comradef191/Cupcake24/Gen3Electronics/Driver-2.3/EAGLE/info.md

These are the original 2008 files, but saved using a version of Eagle I downloaded last year to make them openable in KiCad 8.0
