comradef191/Cupcake24/Gen3Electronics/Extruder-2.2/extruder-controller.kicad_pcb

## KiCad design Gen3Electronics/Extruder-2.2/extruder-controller.kicad_pcb (2024-11-07)

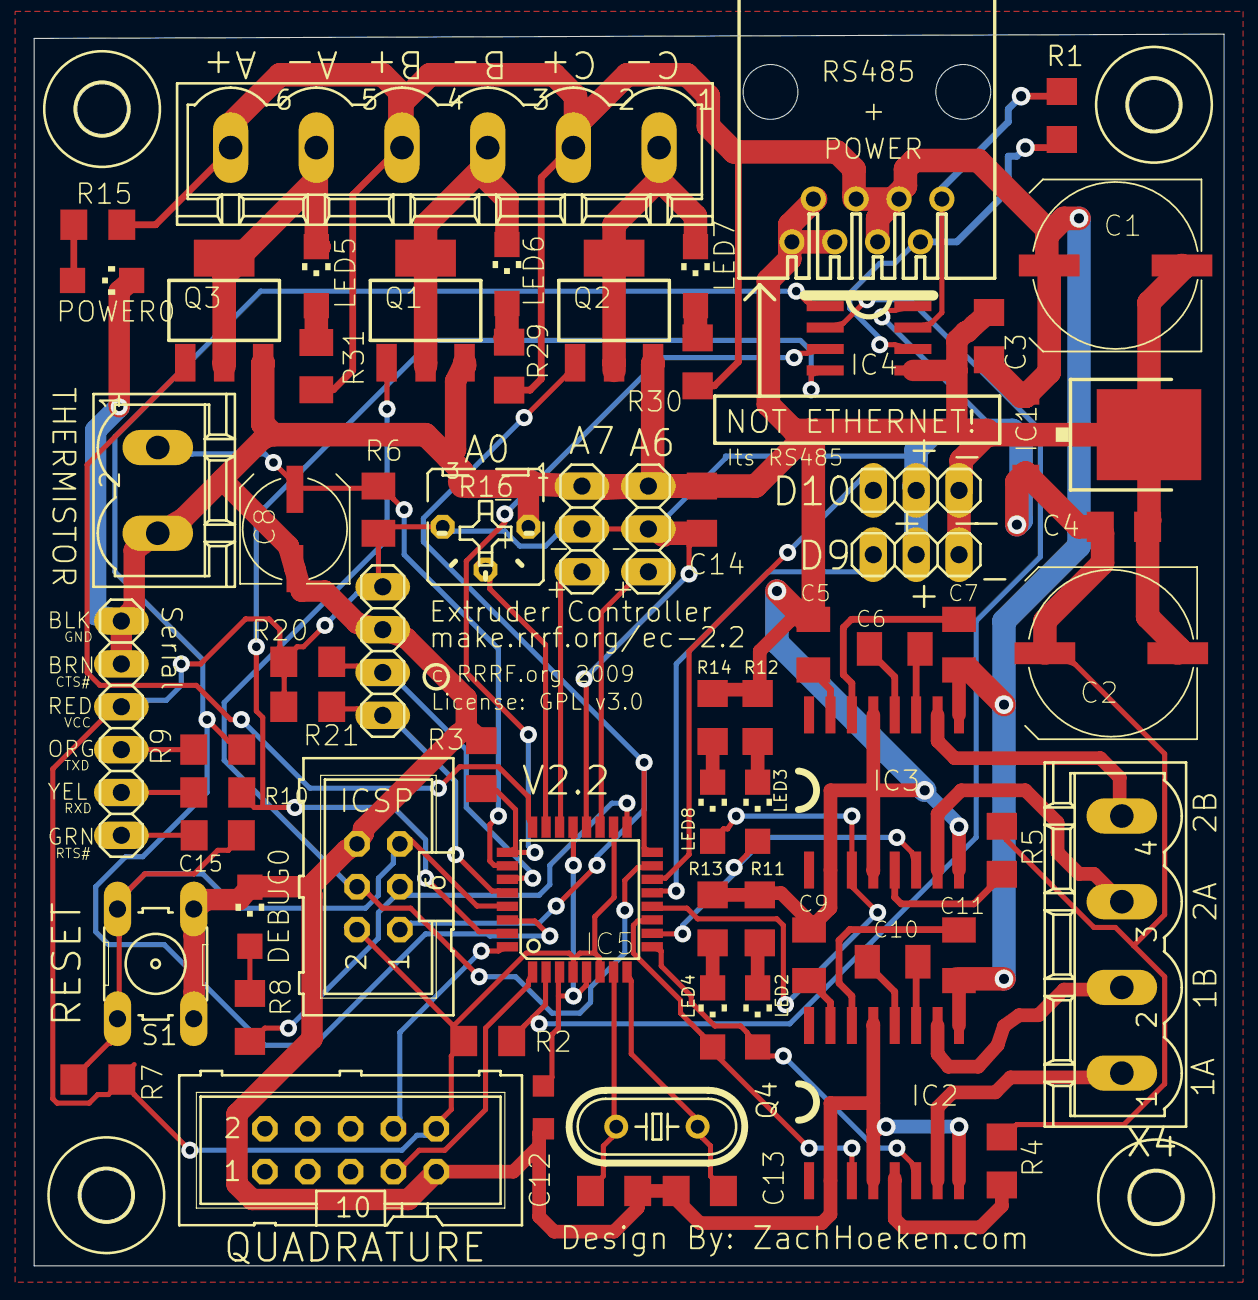
[picture p1: board extruder-controller.kicad_pcb from above]

Board: 2 copper layers, 70.5 x 73.0 mm, 71 parts (0 on the bottom side), 61 nets.

Parts:
C1, C2: 100uF; UD-10X10_NICHICON
C3, C4, C14, C15: 100nF; C1206
C5, C9: .22uF; C1206K
C6, C7, C10, C11: 100nF; C1206K
C8: 10uF; UD-6,3X5,8_NICHICON
C12, C13: 16pf; C1206
DEBUG0: CHIPLED_1206
H1, H2, H3, H4: MOUNT-HOLE3.0; 3,0
IC1: 7805DT; TO252
IC2, IC3: A3949; SO16W
IC4: SN75176ASOIC; SO08
IC5: ATMEGA168; TQFP32-08
J1: 520426-4
JP2, JP3, JP6, JP7: 1X03
JP4: 1X04
JP5: 1X06
LED2: 1; CHIPLED_1206
LED3: 2; CHIPLED_1206
LED4, LED5, LED6, LED7, LED8: CHIPLED_1206
POWER0: CHIPLED_1206
Q1, Q2, Q3: NIF5002; SOT223
Q4: 16MHZ; HC49_S
R1: 180; R1206
R2, R3: 4.7k; R1206
R4, R5, R7: 10K; R1206
R6: 4.7K; M1206
R8, R9, R10, R11, R12, R13, R14, R15, R29, R30: 1K; R1206
R16: B25P
R20, R21: 4.7K; R1206
R31: 1K; M1206
S1: B3F-10XX
SV1: ML6
SV2: ML10
X1: MSTBV6
X3: MSTBV2
X4: MSTBV4

Connections:
+12V: C1.+, C3.1, C7.2, C11.2, IC1.1, IC2.9, IC3.9, J1.3, J1.4, J1.5, R15.2, R29.2, R30.2, R31.2, X1.2, X1.4, X1.6
A0: IC5.23, R16.S
A1: IC5.24, Q3.1
A2: IC4.3, IC5.25, R3.1
A3: C8.+, IC5.26, R6.1, X3.1
A6: IC5.19, JP6.3
A7: IC5.22, JP7.3
D2: IC5.32, SV2.8
D3: IC5.1, SV2.7
D4: IC4.2, IC5.2, R2.1
D5: IC2.6, IC5.9, LED2.A
D6: IC3.6, IC5.10, LED3.A
D7: IC2.3, IC5.11, LED4.A
D8: IC3.3, IC5.12, LED8.A
D9: IC5.13, JP3.3
D10: IC5.14, JP2.3
D11: IC5.15, Q1.1, SV1.4
D12: IC5.16, Q2.1, SV1.1
D13: IC5.17, R8.2, SV1.3
GND: C1.-, C2.-, C3.2, C4.2, C5.1, C8.-, C9.1, C12.1, C13.1, C14.1, DEBUG0.C, IC1.3, IC2.2, IC2.4, IC2.8, IC2.13, IC3.2, IC3.4, IC3.8, IC3.13, IC4.5, J1.6, J1.7, J1.8, JP2.1, JP3.1, JP4.2, JP5.1, JP5.2, JP6.1, JP7.1, POWER0.C, Q1.3, Q2.3, Q3.3, R3.2, R11.2, R12.2, R13.1, R14.1, R16.A, S1.3, S1.4, SV1.6, SV2.9, X3.2
GNDA: IC5.3, IC5.5, IC5.21
unnamed: IC4.7, J1.1, R1.2
unnamed: IC4.6, J1.2, R1.1
unnamed: C9.2, IC2.15
unnamed: IC2.7, X4.1
unnamed: IC2.10, X4.2
unnamed: C10.2, IC2.12
unnamed: C10.1, IC2.11
unnamed: DEBUG0.A, R8.1
unnamed: C11.1, IC2.14
unnamed: IC3.7, X4.3
unnamed: C5.2, IC3.15
unnamed: IC2.5, R4.2
unnamed: C6.2, IC3.12
unnamed: C6.1, IC3.11
unnamed: C7.1, IC3.14
unnamed: IC3.5, R5.2
unnamed: IC3.10, X4.4
unnamed: LED2.C, R11.1
unnamed: LED3.C, R12.1
unnamed: C14.2, IC5.20
unnamed: JP5.5, R10.1
unnamed: JP5.4, R9.1
unnamed: LED4.C, R13.2
unnamed: LED8.C, R14.2
unnamed: POWER0.A, R15.1
unnamed: C12.2, IC5.7, Q4.2
unnamed: C13.2, IC5.8, Q4.1
unnamed: LED7.C, Q2.2, Q2.4, X1.1
unnamed: LED6.C, Q1.2, Q1.4, X1.3
unnamed: LED5.C, Q3.2, Q3.4, X1.5
unnamed: LED5.A, R31.1
unnamed: LED6.A, R29.1
unnamed: LED7.A, R30.1
RESET: C15.1, IC5.29, R7.1, S1.1, S1.2, SV1.5
RTS#: C15.2, JP5.6
RX: IC4.1, IC5.30, R9.2
SCL: IC5.28, JP4.4, R21.1
SDA: IC5.27, JP4.3, R20.1
TX: IC4.4, IC5.31, R10.2
VCC: C2.+, C4.1, IC1.2, IC4.8, IC5.4, IC5.6, IC5.18, JP2.2, JP3.2, JP4.1, JP5.3, JP6.2, JP7.2, R2.2, R4.1, R5.1, R6.2, R7.2, R16.E, R20.2, R21.2, SV1.2, SV2.10
