comradef191/Cupcake24/Gen3Electronics/Motherboard-1.2/motherboard.kicad_pcb

## KiCad design Gen3Electronics/Motherboard-1.2/motherboard.kicad_pcb (2024-11-07)

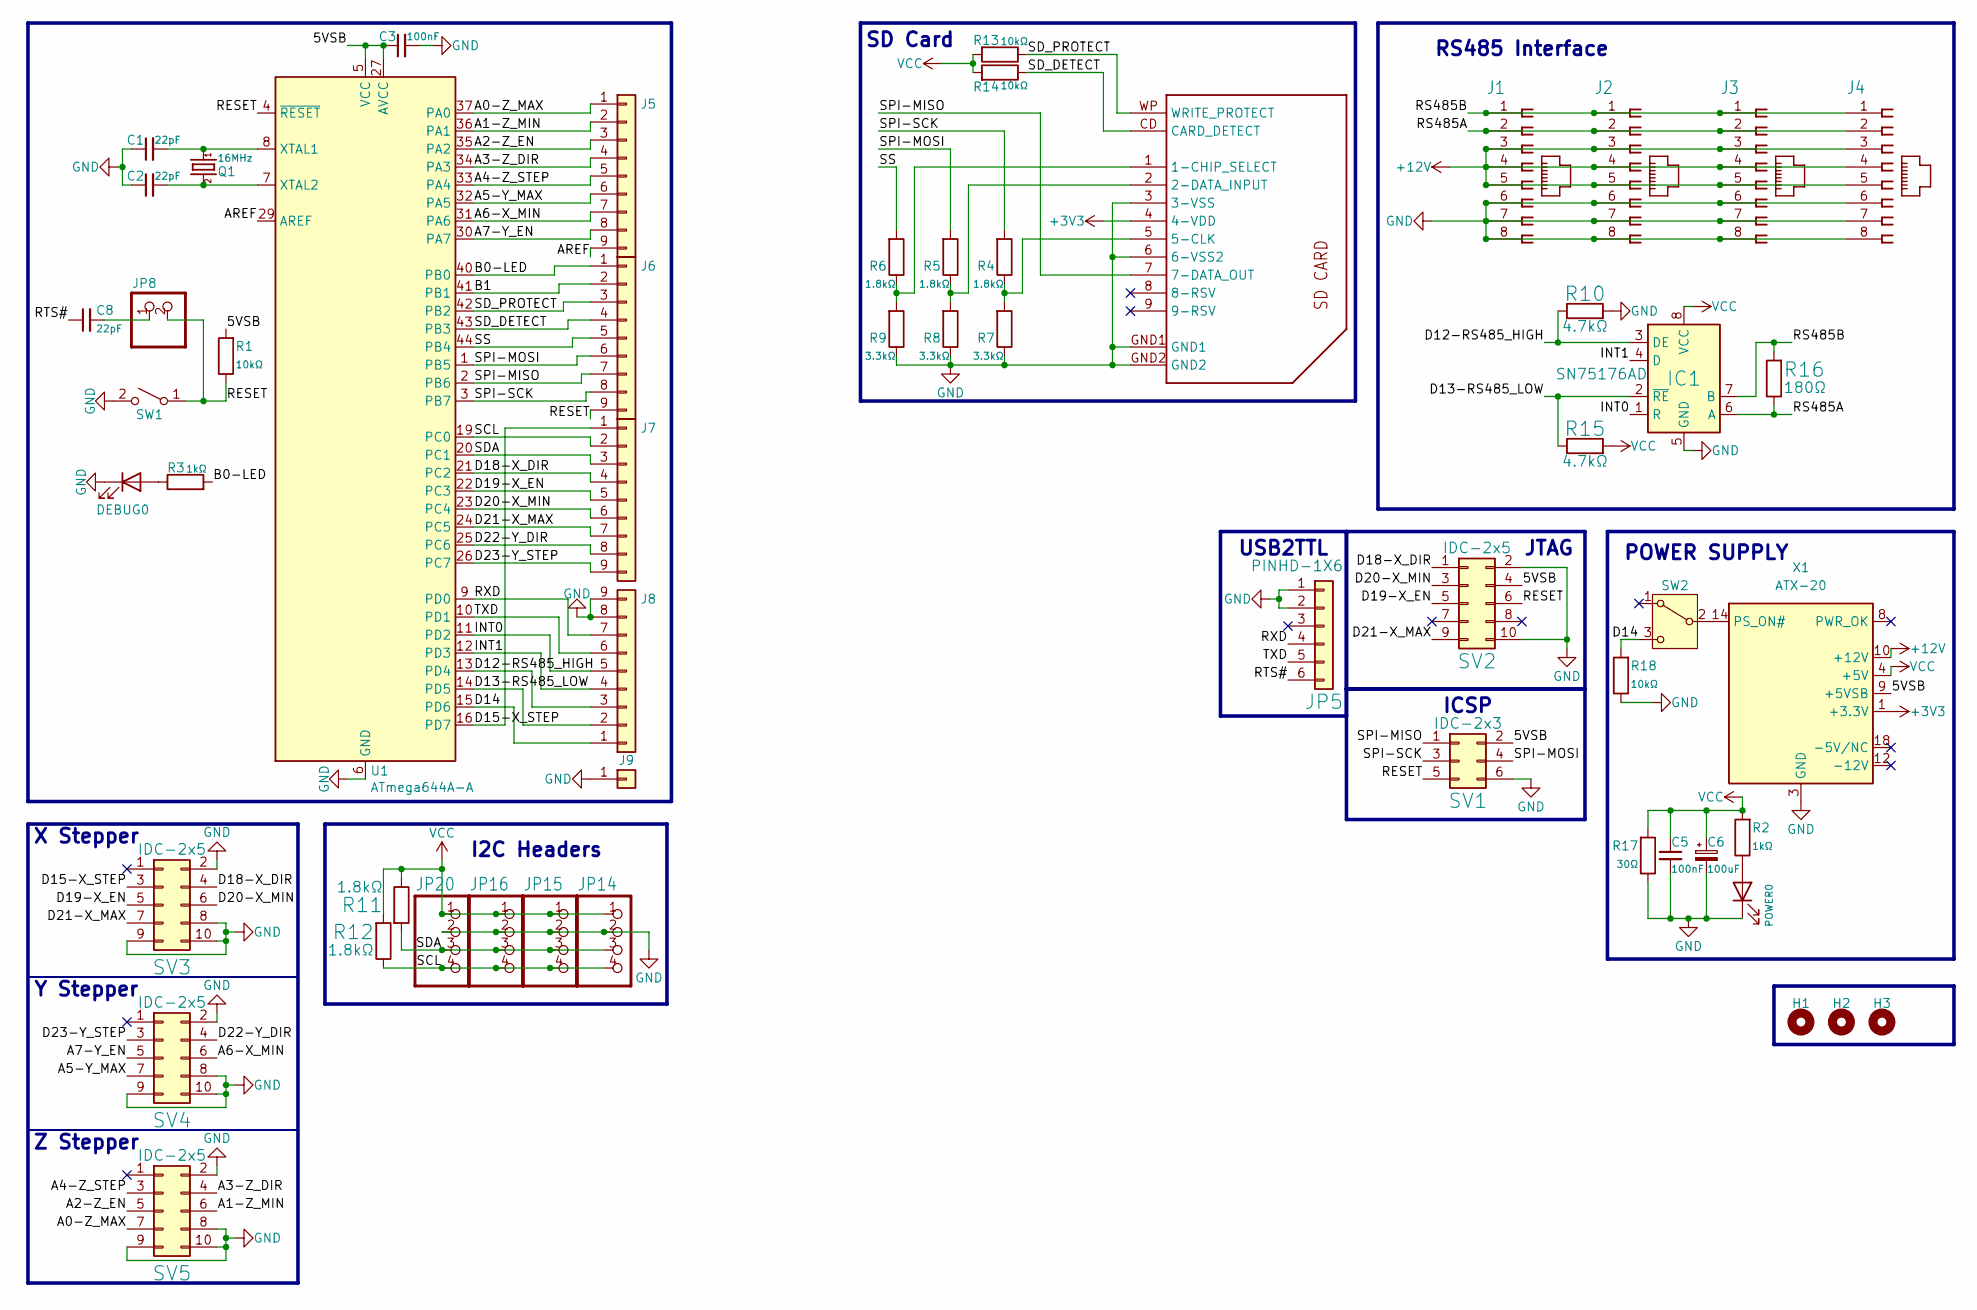
[picture p2: schematic motherboard.kicad_sch, RepRap Motherboard]

Parts:
C1, C2, C8: 22pF; C_1206_3216Metric_Pad1.33x1.80mm_HandSolder
C3, C5: 100nF; C_1206_3216Metric_Pad1.33x1.80mm_HandSolder
C6: 100uF; CP_Radial_D8.0mm_P3.50mm; LCSC C2749
DEBUG0: LEDCHIPLED_1206; LED_1206_3216Metric
H1, H2, H3: M3 Mounting Hole; M3 Mounting Hole ~ Classic
IC1: SN75176AD; SOIC-8_3.9x4.9mm_P1.27mm
J1, J2, J3, J4: 555164-1
J5, J6, J7, J8: Conn_01x09; PinSocket_1x09_P2.54mm_Vertical
J9: Conn_01x01; PinSocket_1x01_P2.54mm_Vertical
JP5: PINHD-1X6; 1X06
JP8: PINHD-1X2; 1X02
JP14, JP15, JP16, JP20: PINHD-1X4; 1X04
POWER0: LEDCHIPLED_1206; LED_1206_3216Metric
Q1: 16MHz; Crystal_HC49-U_Vertical
R1, R13, R14, R18: 10kΩ; R_1206_3216Metric_Pad1.30x1.75mm_HandSolder
R2, R3: 1kΩ; R_1206_3216Metric_Pad1.30x1.75mm_HandSolder
R4, R5, R6, R11, R12: 1.8kΩ; R_1206_3216Metric_Pad1.30x1.75mm_HandSolder
R7, R8, R9: 3.3kΩ; R_1206_3216Metric_Pad1.30x1.75mm_HandSolder
R10, R15: 4.7kΩ; R_1206_3216Metric_Pad1.30x1.75mm_HandSolder
R16: 180Ω; R_1206_3216Metric_Pad1.30x1.75mm_HandSolder
R17: 30Ω; R_Axial_Power_L20.0mm_W6.4mm_P22.40mm; LCSC C334301
SV1: IDC-2x3; IDC-Header_2x03_P2.54mm_Vertical
SV2, SV3, SV4, SV5: IDC-2x5; IDC-Header_2x05_P2.54mm_Vertical
SW1: SW_SPST; SW_PUSH_6mm_H5mm; LCSC C5340135
SW2: SW_SPDT; SW-TH_SHOU-HAN_SS12D10G4
U1: ATmega644A-A; TQFP-44_10x10mm_P0.8mm; LCSC C38349
U$8: SDCARD; 3M-SDCARD
X1: ATX-20; Molex_Mini-Fit_Jr_5566-20A2_2x10_P4.20mm_Vertical

Connections:
+3V3: U$8.4 (4-VDD), X1.1 (+3.3V), X1.2 (+3.3V), X1.11 (+3.3V)
+12V: J1.3, J1.4, J1.5, J2.3, J2.4, J2.5, J3.3, J3.4, J3.5, J4.3, J4.4, J4.5, X1.10 (+12V)
/5VSB: C3.1, R1.2, SV1.2, SV2.4, U1.5 (VCC), U1.17 (VCC), U1.27 (AVCC), U1.38 (VCC), X1.9 (+5VSB)
/A0-Z_MAX: J5.1, SV5.7, U1.37 (PA0)
/A1-Z_MIN: J5.2, SV5.6, U1.36 (PA1)
/A2-Z_EN: J5.3, SV5.5, U1.35 (PA2)
/A3-Z_DIR: J5.4, SV5.4, U1.34 (PA3)
/A4-Z_STEP: J5.5, SV5.3, U1.33 (PA4)
/A5-Y_MAX: J5.6, SV4.7, U1.32 (PA5)
/A6-X_MIN: J5.7, SV4.6, U1.31 (PA6)
/A7-Y_EN: J5.8, SV4.5, U1.30 (PA7)
/AREF: J5.9, U1.29 (AREF)
/B0-LED: J6.1, R3.2, U1.40 (PB0)
/B1: J6.2, U1.41 (PB1)
/D12-RS485_HIGH: IC1.3 (DE), J8.3, R10.1, U1.13 (PD4)
/D13-RS485_LOW: IC1.2 (~RE), J8.2, R15.1, U1.14 (PD5)
/D14: J8.1, R18.2, SW2.3 (C), U1.15 (PD6)
/D15-X_STEP: J7.1, SV3.3, U1.16 (PD7)
/D18-X_DIR: J7.4, SV2.1, SV3.4, U1.21 (PC2)
/D19-X_EN: J7.5, SV2.5, SV3.5, U1.22 (PC3)
/D20-X_MIN: J7.6, SV2.3, SV3.6, U1.23 (PC4)
/D21-X_MAX: J7.7, SV2.9, SV3.7, U1.24 (PC5)
/D22-Y_DIR: J7.8, SV4.4, U1.25 (PC6)
/D23-Y_STEP: J7.9, SV4.3, U1.26 (PC7)
/INT0: IC1.1 (R), J8.5, U1.11 (PD2)
/INT1: IC1.4 (D), J8.4, U1.12 (PD3)
/RESET: J6.9, JP8.2, R1.1, SV1.5, SV2.6, SW1.1 (A), U1.4 (~RESET)
/RS485A: IC1.6 (A), J1.2, J2.2, J3.2, J4.2, R16.1
/RS485B: IC1.7 (B), J1.1, J2.1, J3.1, J4.1, R16.2
/RTS#: C8.1, JP5.6
/RXD: J8.7, JP5.4, U1.9 (PD0)
/SCL: J7.2, JP14.4, JP15.4, JP16.4, JP20.4, R12.1, U1.19 (PC0)
/SDA: J7.3, JP14.3, JP15.3, JP16.3, JP20.3, R11.2, U1.20 (PC1)
/SD_DETECT: J6.4, R14.1, U1.43 (PB3), U$8.CD (CARD_DETECT)
/SD_PROTECT: J6.3, R13.1, U1.42 (PB2), U$8.WP (WRITE_PROTECT)
/SPI-MISO: J6.7, SV1.1, U1.2 (PB6), U$8.7 (7-DATA_OUT)
/SPI-MOSI: J6.6, R5.2, SV1.4, U1.1 (PB5)
/SPI-SCK: J6.8, R4.2, SV1.3, U1.3 (PB7)
/SS: J6.5, R6.2, U1.44 (PB4)
/TXD: J8.6, JP5.5, U1.10 (PD1)
GND: C1.1, C2.1, C3.2, C5.2, C6.2, DEBUG0.1 (K), IC1.5 (GND), J1.6, J1.7, J1.8, J2.6, J2.7, J2.8, J3.6, J3.7, J3.8, J4.6, J4.7, J4.8, J8.8, J8.9, J9.1, JP5.1, JP5.2, JP14.2, JP15.2, JP16.2, JP20.2, POWER0.1 (K), R7.1, R8.1, R9.1, R10.2, R17.1, R18.1, SV1.6, SV2.2, SV2.10, SV3.2, SV3.8, SV3.9, SV3.10, SV4.2, SV4.8, SV4.9, SV4.10, SV5.2, SV5.8, SV5.9, SV5.10, SW1.2 (B), U1.6 (GND), U1.18 (GND), U1.28 (GND), U1.39 (GND), U$8.3 (3-VSS), U$8.6 (6-VSS2), U$8.GND1, U$8.GND2, X1.3 (GND), X1.5 (GND), X1.7 (GND), X1.13 (GND), X1.15 (GND), X1.16 (GND), X1.17 (GND)
unnamed: C8.2, JP8.1
unnamed: DEBUG0.2 (A), R3.1
unnamed: POWER0.2 (A), R2.1
unnamed: SW2.2 (B), X1.14 (PS_ON#)
unnamed: C1.2, Q1.1, U1.8 (XTAL1)
unnamed: C2.2, Q1.2, U1.7 (XTAL2)
unnamed: R6.1, R9.2, U$8.1 (1-CHIP_SELECT)
unnamed: R5.1, R8.2, U$8.2 (2-DATA_INPUT)
unnamed: R4.1, R7.2, U$8.5 (5-CLK)
VCC: C5.1, C6.1, IC1.8 (VCC), JP14.1, JP15.1, JP16.1, JP20.1, R2.2, R11.1, R12.2, R13.2, R14.2, R15.2, R17.2, X1.4 (+5V), X1.6 (+5V), X1.19 (+5V), X1.20 (+5V)

Notes on the sheet:
Z Stepper
USB2TTL
SD Card
JTAG
RS485 Interface
Y Stepper
ICSP
X Stepper
POWER SUPPLY
I2C Headers

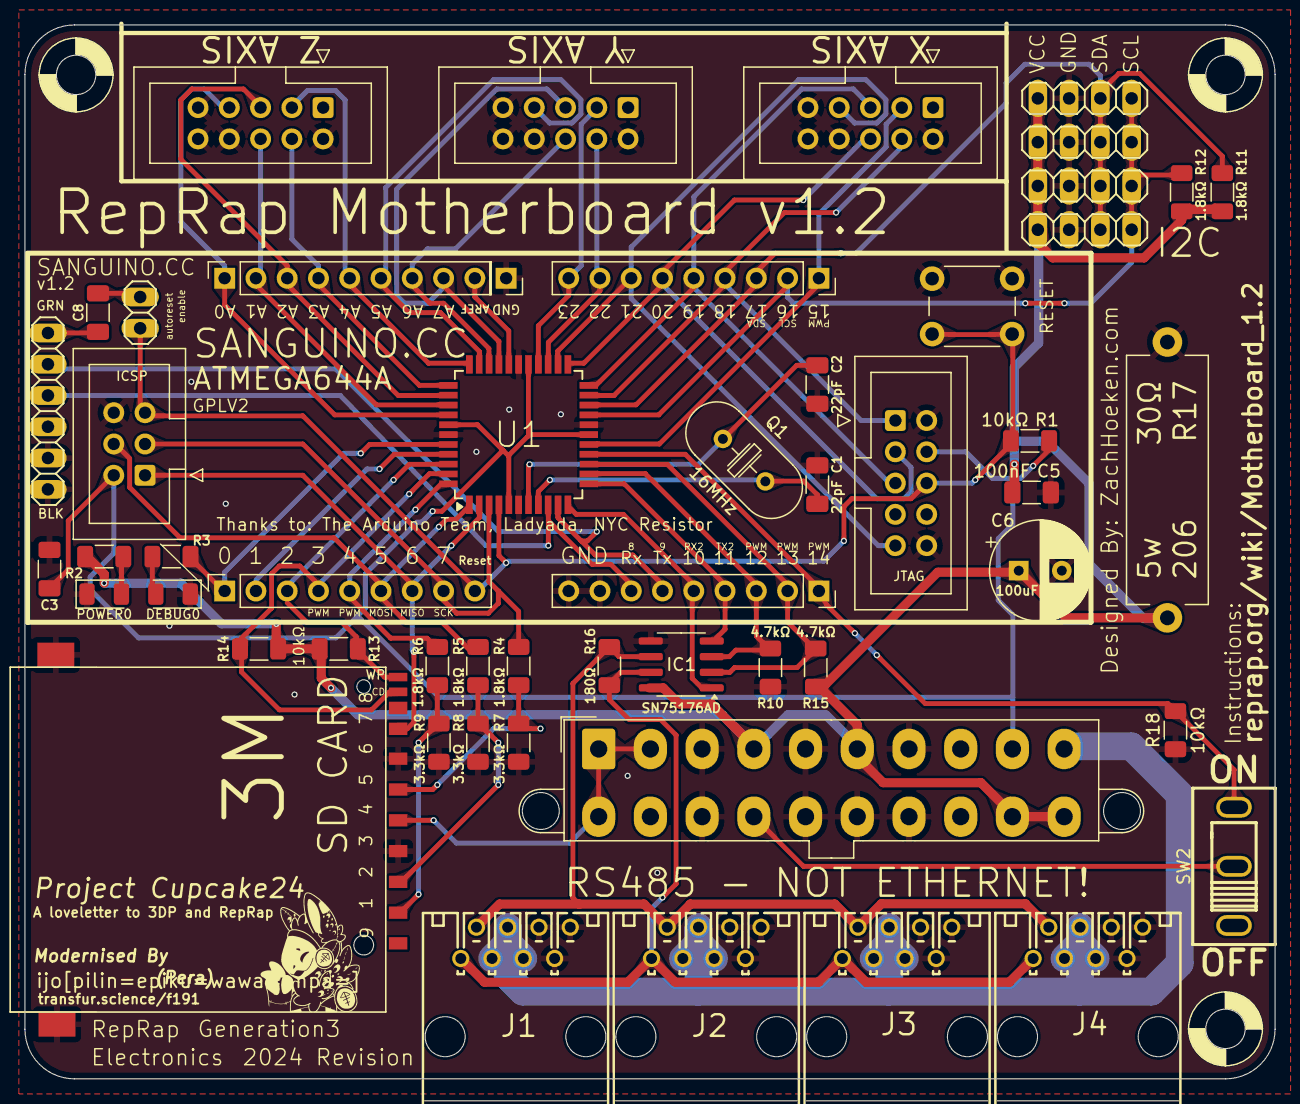
[picture p3: board motherboard.kicad_pcb from above]

Board: 2 copper layers, 101.5 x 85.6 mm, 56 parts (0 on the bottom side), 51 nets.
