comradef191/Cupcake24/Gen3Electronics/Driver-2.3/stepper-motor-driver.kicad_pcb

## KiCad design Gen3Electronics/Driver-2.3/stepper-motor-driver.kicad_pcb (2024-11-07)

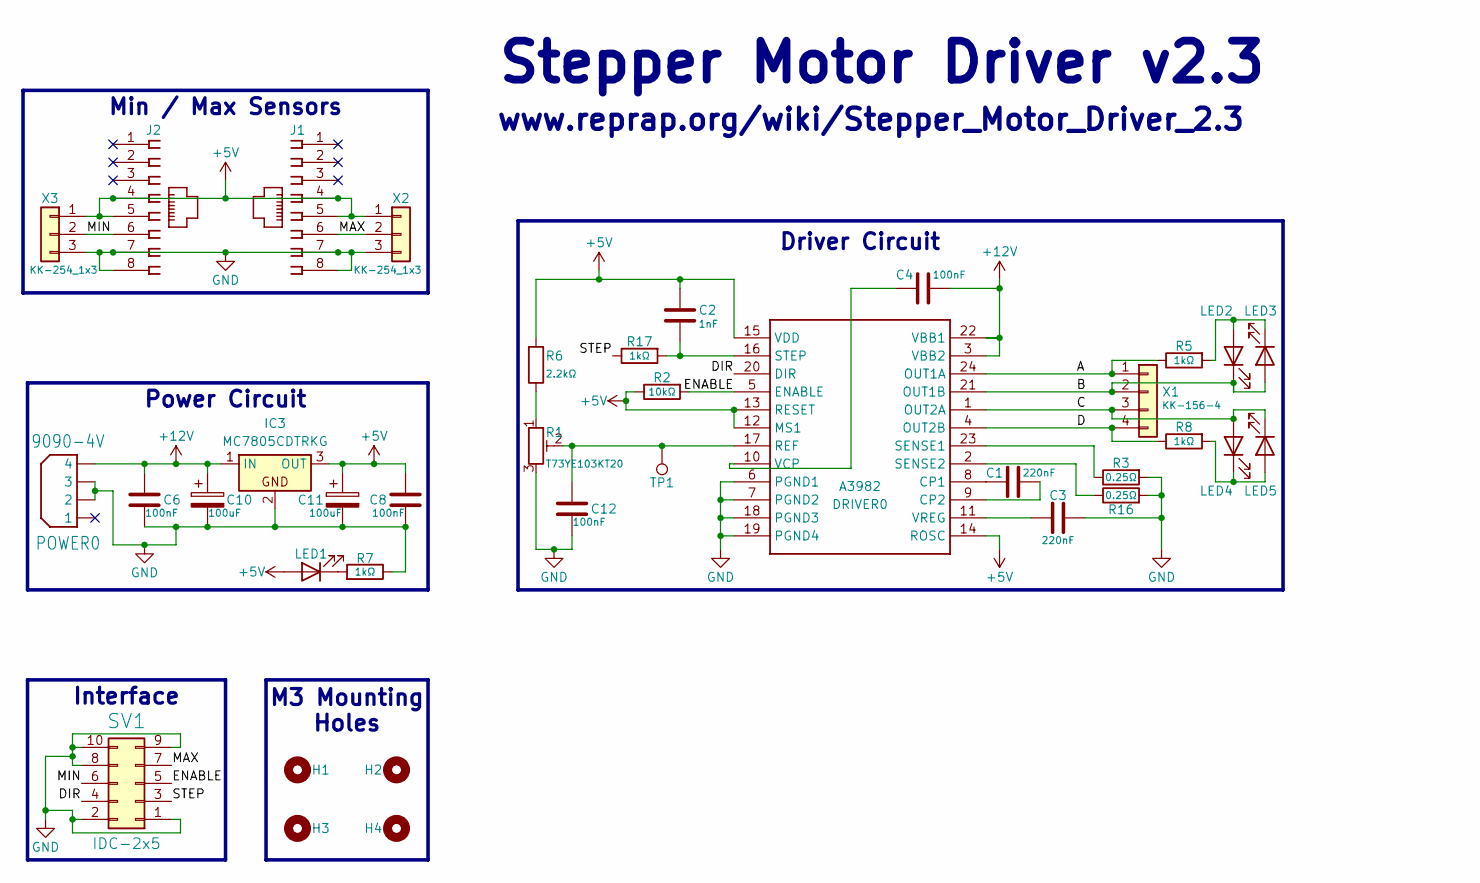
[picture p4: schematic stepper-motor-driver.kicad_sch, Generation 3 Electronics - Motor Driver]

Parts:
C1, C3: 220nF; C_1206_3216Metric_Pad1.33x1.80mm_HandSolder; LCSC C377090
C2: 1nF; C_1206_3216Metric_Pad1.33x1.80mm_HandSolder; LCSC C5448899
C4, C6, C8, C12: 100nF; C_1206_3216Metric_Pad1.33x1.80mm_HandSolder; LCSC C841554
C10, C11: 100uF; CP_Elec_10x10; LCSC C250828
DRIVER0: A3982; SOIC-24W_7.5x15.4mm_P1.27mm
H1, H2, H3, H4: MountingHole; M3 Mounting Hole ~ Classic
IC3: MC7805CDTRKG; TO-252-2; LCSC C54285
J1, J2: 520426-4; LCSC C3000202
LED1, LED2, LED3: GREEN; LED_1206_3216Metric_Pad1.42x1.75mm_HandSolder; LCSC C2980185
LED4, LED5: RED; LED_1206_3216Metric_Pad1.42x1.75mm_HandSolder; LCSC C2892757
POWER0: 9090-4V; LCSC C492551
R1: T73YE103KT20; Potentiometer_Vishay_T73YP_Vertical; LCSC C58159
R2: 10kΩ; R_1206_3216Metric_Pad1.30x1.75mm_HandSolder; LCSC C2907423
R3, R16: 0.25Ω; R_2512_6332Metric_Pad1.52x3.35mm_HandSolder; LCSC C25467
R5, R7, R8, R17: 1kΩ; R_1206_3216Metric_Pad1.30x1.75mm_HandSolder; LCSC C2907440
R6: 2.2kΩ; R_1206_3216Metric_Pad1.30x1.75mm_HandSolder; LCSC C26038
SV1: IDC-2x5; IDC-Header_2x05_P2.54mm_Vertical; LCSC C429962
TP1: TestPoint; P1-13
X1: KK-156-4; LCSC C10379
X2, X3: KK-254_1x3; Molex_KK-254_AE-6410-03A_1x03_P2.54mm_Vertical

Connections:
+5V: C2.2, C8.2, C11.1, DRIVER0.12 (MS1), DRIVER0.13 (RESET), DRIVER0.14 (ROSC), DRIVER0.15 (VDD), IC3.3 (OUT), J1.4, J1.5, J2.4, J2.5, LED1.2 (A), R2.1, R6.2, X2.1, X3.1
+12V: C4.2, C6.2, C10.1, DRIVER0.3 (VBB2), DRIVER0.22 (VBB1), IC3.1 (IN), POWER0.4
/A: DRIVER0.24 (OUT1A), R5.1, X1.1
/B: DRIVER0.21 (OUT1B), LED2.1 (K), LED3.2 (A), X1.2
/C: DRIVER0.1 (OUT2A), LED4.2 (A), LED5.1 (K), X1.3
/D: DRIVER0.4 (OUT2B), R8.1, X1.4
/DIR: DRIVER0.20 (DIR), SV1.4
/ENABLE: DRIVER0.5 (ENABLE), R2.2, SV1.5
/MAX: J1.6, SV1.7, X2.2
/MIN: J2.6, SV1.6, X3.2
/STEP: R17.1, SV1.3
GND: C3.2, C6.1, C8.1, C10.2, C11.2, C12.1, DRIVER0.6 (PGND1), DRIVER0.7 (PGND2), DRIVER0.18 (PGND3), DRIVER0.19 (PGND4), IC3.2, J1.7, J1.8, J2.7, J2.8, POWER0.2, POWER0.3, R1.3, R3.2, R7.1, R16.2, SV1.1, SV1.2, SV1.8, SV1.9, SV1.10, X2.3, X3.3
unnamed: C1.1, DRIVER0.8 (CP1)
unnamed: C1.2, DRIVER0.9 (CP2)
unnamed: C12.2, DRIVER0.17 (REF), R1.2, TP1.1
unnamed: DRIVER0.23 (SENSE1), R3.1
unnamed: DRIVER0.2 (SENSE2), R16.1
unnamed: C2.1, DRIVER0.16 (STEP), R17.2
unnamed: C4.1, DRIVER0.10 (VCP)
unnamed: C3.1, DRIVER0.11 (VREG)
unnamed: LED1.1 (K), R7.2
unnamed: LED2.2 (A), LED3.1 (K), R5.2
unnamed: LED4.1 (K), LED5.2 (A), R8.2
unnamed: R1.1, R6.1

Notes on the sheet:
www.reprap.org/wiki/Stepper_Motor_Driver_2.3
Power Circuit
Interface
Stepper Motor Driver v2.3
M3 Mounting Holes
Min / Max Sensors
Driver Circuit

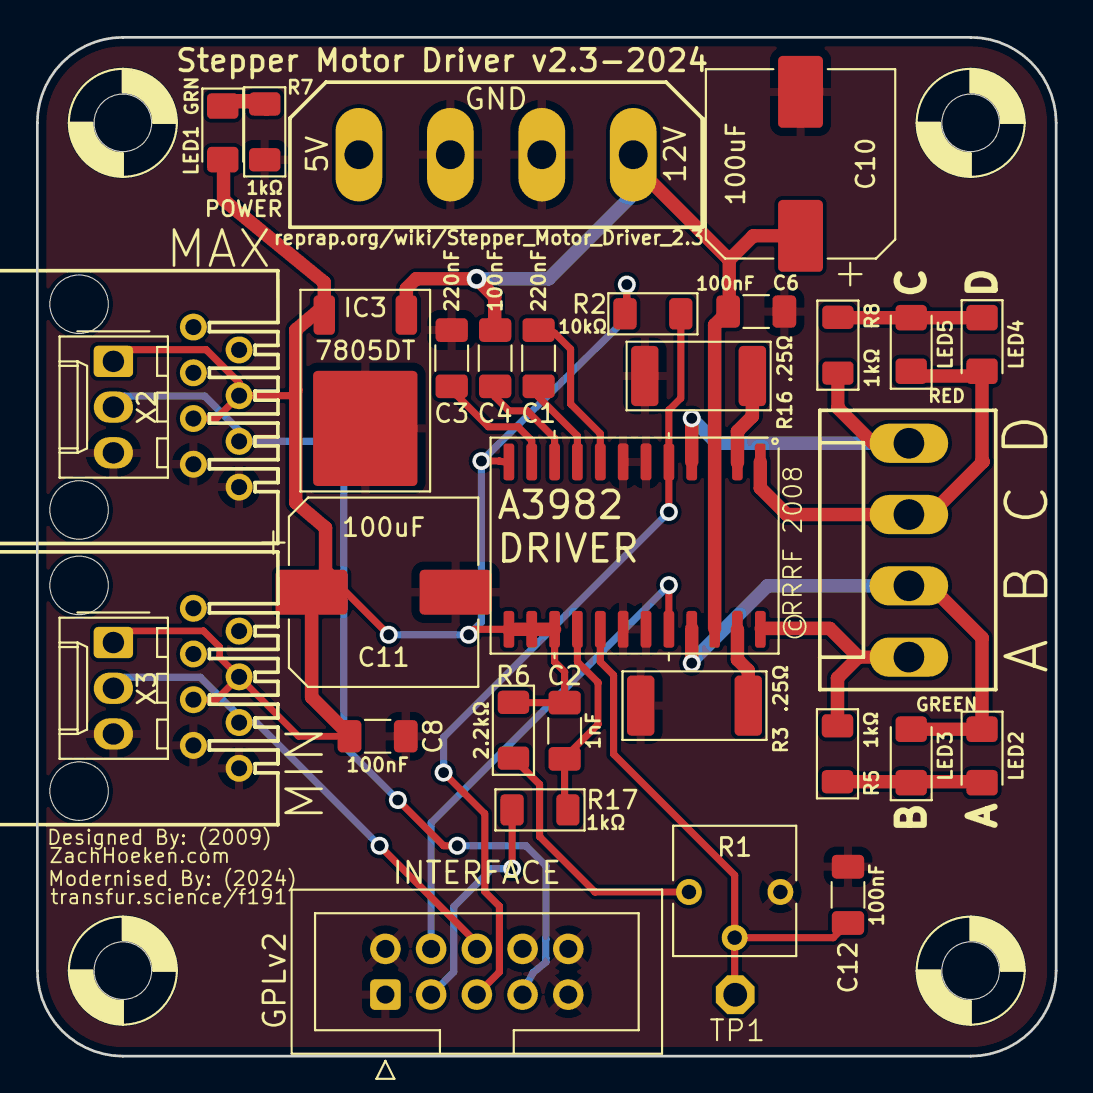
[picture p5: board stepper-motor-driver.kicad_pcb from above]

Board: 2 copper layers, 56.6 x 56.6 mm, 37 parts (0 on the bottom side), 24 nets.
