comradef191/Cupcake24/Gen3Electronics/Driver-2.3/EAGLE/stepper-motor-driver.brd

## EAGLE design Gen3Electronics/Driver-2.3/EAGLE/stepper-motor-driver.brd (2024-11-07)

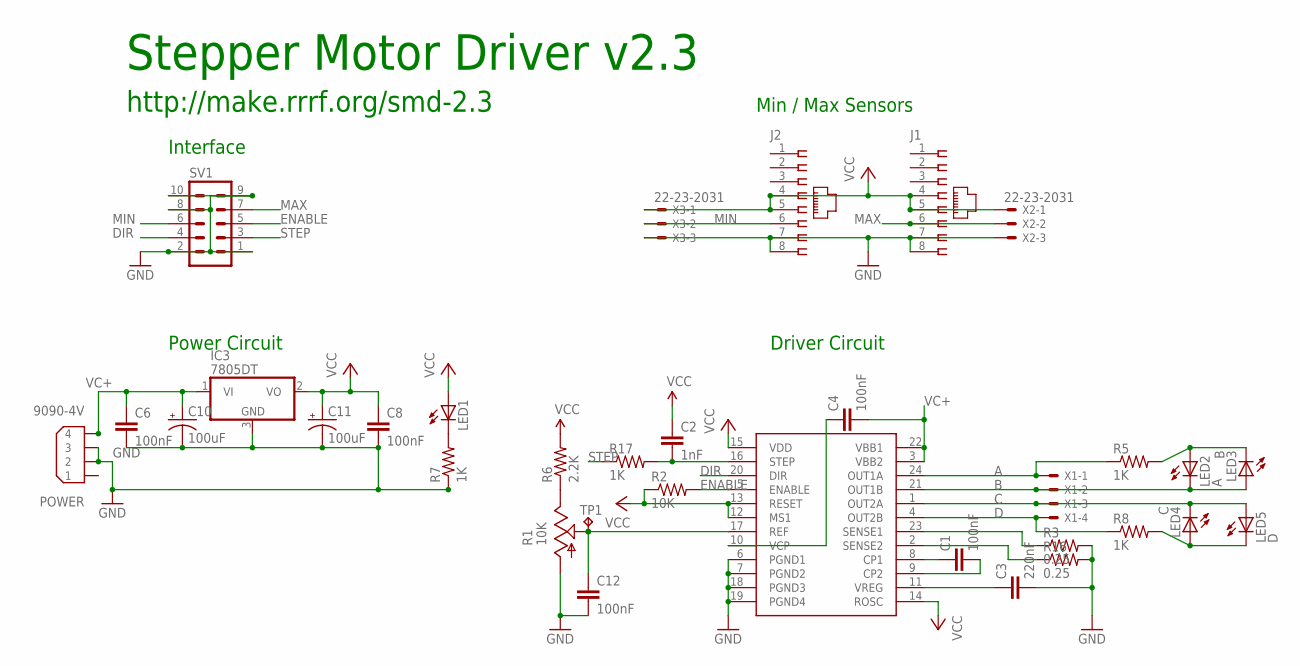
[picture p6: schematic stepper-motor-driver.sch]

Parts:
C1, C4, C12: 100nF; C1206
C2: 1nF; C1206K
C3: 220nF; C1206
C6, C8: 100nF; C1206K
C10, C11: 100uF; UD-10X10_NICHICON
DRIVER: A3982; SO24W
IC3: 7805DT; TO252
J1, J2: 520426-4
LED1: LEDCHIPLED_1206; CHIPLED_1206
LED2: A; CHIPLED_1206
LED3: B; CHIPLED_1206
LED4: C; CHIPLED_1206
LED5: D; CHIPLED_1206
POWER: 9090-4V
R1: 10K; B25P
R2: 10K; R1206
R3, R16: 0.25; R2512
R5, R7, R8, R17: 1K; R1206
R6: 2.2K; R1206
SV1: ML10
TP1: TPPAD1-13; P1-13
X1: KK-156-4
X2, X3: 22-23-2031

Connections:
A: DRIVER.24 (OUT1A), R5.1, X1.1
B: DRIVER.21 (OUT1B), LED2.C, LED3.A, X1.2
C: DRIVER.1 (OUT2A), LED4.C, LED5.A, X1.3
D: DRIVER.4 (OUT2B), R8.1, X1.4
DIR: DRIVER.20 (DIR), SV1.4
ENABLE: DRIVER.5 (ENABLE), R2.2, SV1.5
GND: C3.2, C6.2, C8.2, C10.-, C11.-, C12.2, DRIVER.6 (PGND1), DRIVER.7 (PGND2), DRIVER.18 (PGND3), DRIVER.19 (PGND4), IC3.3 (GND), J1.7, J1.8, J2.7, J2.8, POWER.2, POWER.3, R1.A, R3.2, R7.1, R16.2, SV1.1, SV1.2, SV1.8, SV1.9, SV1.10, X2.3, X3.3
MAX: J1.6, SV1.7, X2.2
MIN: J2.6, SV1.6, X3.2
unnamed: DRIVER.23 (SENSE1), R3.1
unnamed: DRIVER.2 (SENSE2), R16.1
unnamed: C1.1, DRIVER.8 (CP1)
unnamed: C1.2, DRIVER.9 (CP2)
unnamed: C3.1, DRIVER.11 (VREG)
unnamed: R1.E, R6.1
unnamed: C4.1, DRIVER.10 (VCP)
unnamed: LED1.C, R7.2
unnamed: LED2.A, LED3.C, R5.2
unnamed: LED4.A, LED5.C, R8.2
unnamed: C12.1, DRIVER.17 (REF), R1.S, TP1.1
unnamed: C2.2, DRIVER.16 (STEP), R17.2
STEP: R17.1, SV1.3
VC+: C4.2, C6.1, C10.+, DRIVER.3 (VBB2), DRIVER.22 (VBB1), IC3.1 (VI), POWER.4
VCC: C2.1, C8.1, C11.+, DRIVER.12 (MS1), DRIVER.13 (RESET), DRIVER.14 (ROSC), DRIVER.15 (VDD), IC3.2 (VO), J1.4, J1.5, J2.4, J2.5, LED1.A, R2.1, R6.2, X2.1, X3.1

Notes on the sheet:
Interface
Driver Circuit
Min / Max Sensors
Stepper Motor Driver v2.3
http://make.rrrf.org/smd-2.3
Power Circuit

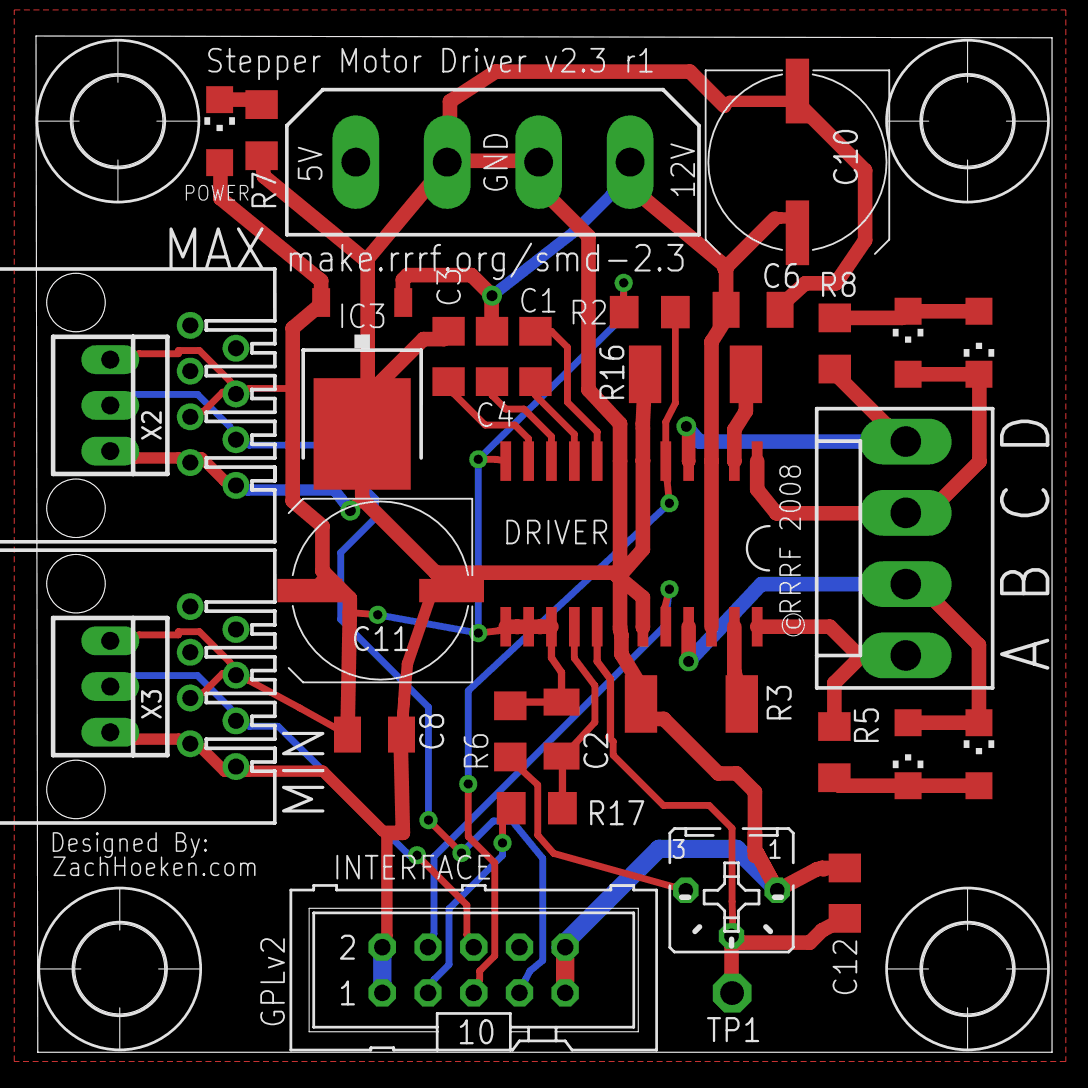
[picture p7: board stepper-motor-driver.brd from above]

Board: 2 copper layers, 56.4 x 56.5 mm, 37 parts (0 on the bottom side), 24 nets.

Other parts of the board:
U$1, U$2, U$3, U$4: 5,0
