comradef191/Cupcake24/Gen3Electronics/Motherboard-1.2/EAGLE/motherboard.brd

## EAGLE design Gen3Electronics/Motherboard-1.2/EAGLE/motherboard.brd (2024-11-07)

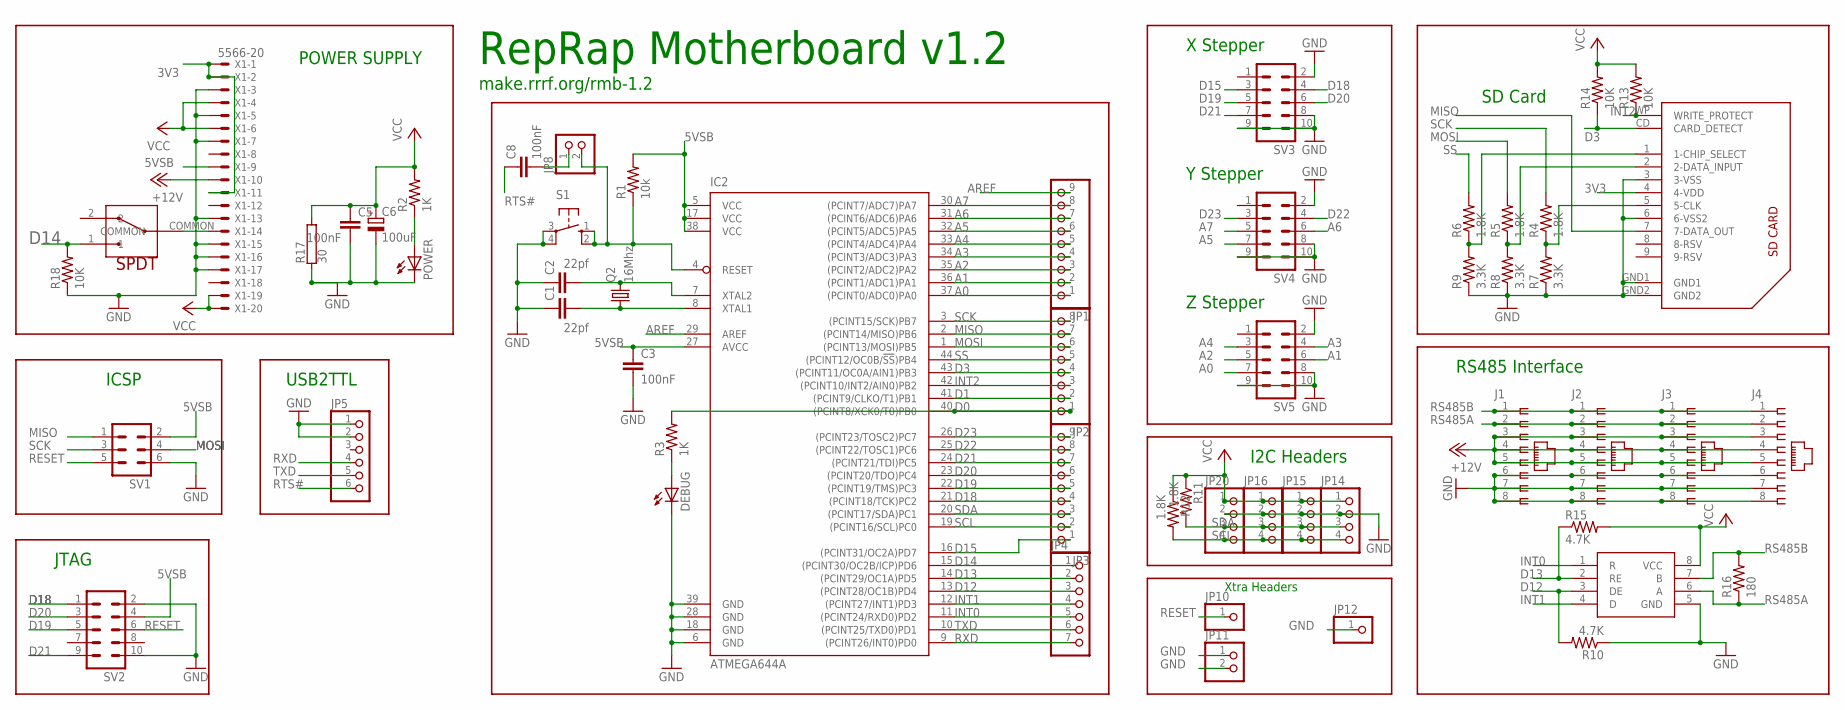
[picture p8: schematic motherboard.sch]

Parts:
C1, C2: 22pf; C1206
C3, C5, C8: 100nF; C1206
C6: 100uF; SANYO-OSCON_SMD_B6
DEBUG: LEDCHIPLED_1206; CHIPLED_1206
IC1: SN75176ASOIC; SO08
IC2: ATMEGA644A; TQFP44
J1, J2, J3, J4: 555164-1
JP1, JP3: PINHD-1X9; 1X09
JP2: PINHD-1X8; 1X08
JP4: PINHD-1X7; 1X07
JP5: PINHD-1X6; 1X06
JP8, JP11: PINHD-1X2; 1X02
JP10, JP12: PINHD-1X1; 1X01
JP14, JP15, JP16, JP20: PINHD-1X4; 1X04
POWER: LEDCHIPLED_1206; CHIPLED_1206
Q2: 16Mhz; HC49U-V
R1: 10k; R1206
R2, R3: 1K; R1206
R4, R5, R6, R11, R12: 1.8K; R1206
R7, R8, R9: 3.3K; R1206
R10, R15: 4.7K; R1206
R13, R14, R18: 10K; R1206
R16: 180; R1206
R17: 30; KH206-8
S1: 10-XX; B3F-10XX
SV1: ML6
SV2, SV3, SV4, SV5: ML10
U$2: SPDT; 10SP001
U$8: SDCARD; 3M-SDCARD
X1: 5566-20

Connections:
3V3: U$8.4 (4-VDD), X1.1, X1.2, X1.11
5VSB: C3.1, IC2.5 (VCC), IC2.17 (VCC), IC2.27 (AVCC), IC2.38 (VCC), R1.2, SV1.2, SV2.4, X1.9
+12V: J1.3, J1.4, J1.5, J2.3, J2.4, J2.5, J3.3, J3.4, J3.5, J4.3, J4.4, J4.5, X1.10
A0: IC2.37 ((PCINT0/ADC0)PA0), JP1.1, SV5.7
A1: IC2.36 ((PCINT1/ADC1)PA1), JP1.2, SV5.6
A2: IC2.35 ((PCINT2/ADC2)PA2), JP1.3, SV5.5
A3: IC2.34 ((PCINT3/ADC3)PA3), JP1.4, SV5.4
A4: IC2.33 ((PCINT4/ADC4)PA4), JP1.5, SV5.3
A5: IC2.32 ((PCINT5/ADC5)PA5), JP1.6, SV4.7
A6: IC2.31 ((PCINT6/ADC6)PA6), JP1.7, SV4.6
A7: IC2.30 ((PCINT7/ADC7)PA7), JP1.8, SV4.5
AREF: IC2.29 (AREF), JP1.9
D0: IC2.40 ((PCINT8/XCK0/T0)PB0), JP2.1, R3.2
D1: IC2.41 ((PCINT9/CLKO/T1)PB1), JP2.2
D3: IC2.43 ((PCINT11/OC0A/AIN1)PB3), JP2.4, R14.1, U$8.CD (CARD_DETECT)
D12: IC1.3 (DE), IC2.13 ((PCINT28/OC1B)PD4), JP4.3, R10.2
D13: IC1.2 (RE), IC2.14 ((PCINT29/OC1A)PD5), JP4.2, R15.1
D14: IC2.15 ((PCINT30/OC2B/ICP)PD6), JP4.1, R18.2, U$2.1
D15: IC2.16 ((PCINT31/OC2A)PD7), JP3.1, SV3.3
D18: IC2.21 ((PCINT18/TCK)PC2), JP3.4, SV2.1, SV3.4
D19: IC2.22 ((PCINT19/TMS)PC3), JP3.5, SV2.5, SV3.5
D20: IC2.23 ((PCINT20/TDO)PC4), JP3.6, SV2.3, SV3.6
D21: IC2.24 ((PCINT21/TDI)PC5), JP3.7, SV2.9, SV3.7
D22: IC2.25 ((PCINT22/TOSC1)PC6), JP3.8, SV4.4
D23: IC2.26 ((PCINT23/TOSC2)PC7), JP3.9, SV4.3
GND: C1.1, C2.1, C3.2, C5.2, C6.-, DEBUG.C, IC1.5 (GND), IC2.6 (GND), IC2.18 (GND), IC2.28 (GND), IC2.39 (GND), J1.6, J1.7, J1.8, J2.6, J2.7, J2.8, J3.6, J3.7, J3.8, J4.6, J4.7, J4.8, JP5.1, JP5.2, JP11.1, JP11.2, JP12.1, JP14.2, JP15.2, JP16.2, JP20.2, POWER.C, R7.1, R8.1, R9.1, R10.1, R17.1, R18.1, S1.3, S1.4 (P1), SV1.6, SV2.2, SV2.10, SV3.2, SV3.8, SV3.9, SV3.10, SV4.2, SV4.8, SV4.9, SV4.10, SV5.2, SV5.8, SV5.9, SV5.10, U$8.3 (3-VSS), U$8.6 (6-VSS2), U$8.GND1, U$8.GND2, X1.3, X1.5, X1.7, X1.13, X1.15, X1.16, X1.17
INT0: IC1.1 (R), IC2.11 ((PCINT24/RXD0)PD2), JP4.5
INT1: IC1.4 (D), IC2.12 ((PCINT27/INT1)PD3), JP4.4
INT2: IC2.42 ((PCINT10/INT2/AIN0)PB2), JP2.3, R13.1, U$8.WP (WRITE_PROTECT)
MISO: IC2.2 ((PCINT14/MISO)PB6), JP2.7, SV1.1, U$8.7 (7-DATA_OUT)
MOSI: IC2.1 ((PCINT13/MOSI)PB5), JP2.6, R5.2, SV1.4
unnamed: C2.2, IC2.7 (XTAL2), Q2.2
unnamed: POWER.A, R2.1
unnamed: U$2.COMMON, X1.14
unnamed: DEBUG.A, R3.1
unnamed: C1.2, IC2.8 (XTAL1), Q2.1
unnamed: R6.1, R9.2, U$8.1 (1-CHIP_SELECT)
unnamed: R5.1, R8.2, U$8.2 (2-DATA_INPUT)
unnamed: C8.2, JP8.1
unnamed: R4.1, R7.2, U$8.5 (5-CLK)
RESET: IC2.4 (RESET), JP8.2, JP10.1, R1.1, S1.1 (S), S1.2 (S1), SV1.5, SV2.6
RS485A: IC1.6 (A), J1.2, J2.2, J3.2, J4.2, R16.1
RS485B: IC1.7 (B), J1.1, J2.1, J3.1, J4.1, R16.2
RTS#: C8.1, JP5.6
RXD: IC2.9 ((PCINT26/INT0)PD0), JP4.7, JP5.4
SCK: IC2.3 ((PCINT15/SCK)PB7), JP2.8, R4.2, SV1.3
SCL: IC2.19 ((PCINT16/SCL)PC0), JP3.2, JP14.4, JP15.4, JP16.4, JP20.4, R12.2
SDA: IC2.20 ((PCINT17/SDA)PC1), JP3.3, JP14.3, JP15.3, JP16.3, JP20.3, R11.2
SS: IC2.44 ((PCINT12/OC0B/!SS!)PB4), JP2.5, R6.2
TXD: IC2.10 ((PCINT25/TXD0)PD1), JP4.6, JP5.5
VCC: C5.1, C6.+, IC1.8 (VCC), JP14.1, JP15.1, JP16.1, JP20.1, R2.2, R11.1, R12.1, R13.2, R14.2, R15.2, R17.2, X1.4, X1.6, X1.19, X1.20

Notes on the sheet:
ICSP
USB2TTL
POWER SUPPLY
RepRap Motherboard v1.2
make.rrrf.org/rmb-1.2
JTAG
Xtra Headers
Z Stepper
Y Stepper
X Stepper
SD Card
I2C Headers
RS485 Interface

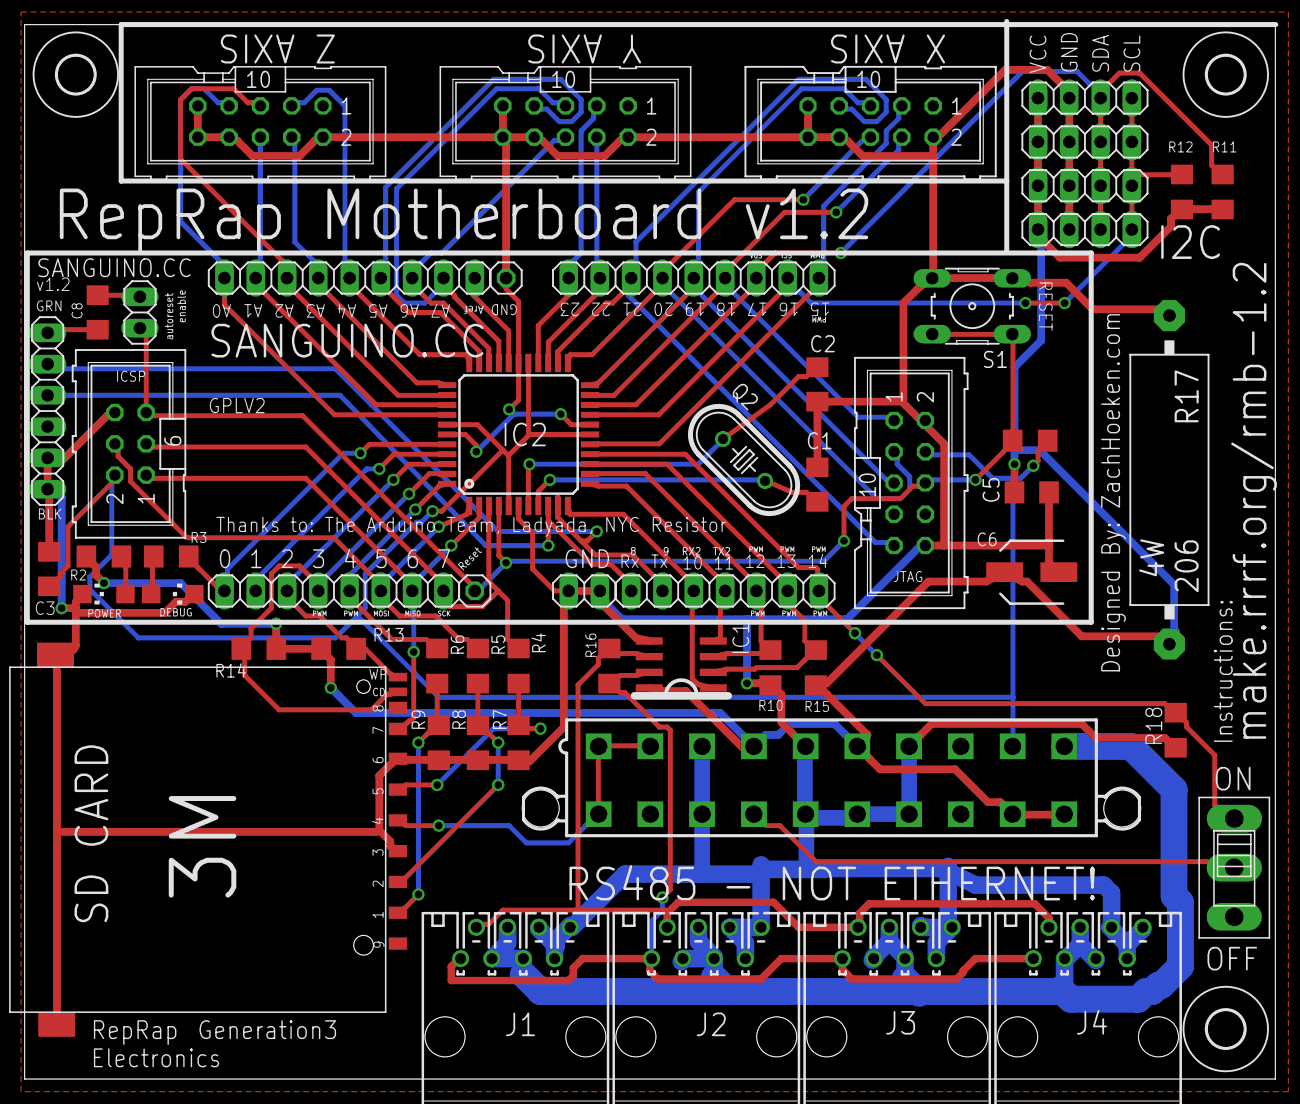
[picture p9: board motherboard.brd from above]

Board: 2 copper layers, 101.5 x 85.6 mm, 58 parts (0 on the bottom side), 51 nets.

Other parts of the board:
U$3, U$4, U$5: 3,0
