comradef191/Cupcake24/Gen3Electronics/Extruder-2.2/EAGLE/extruder-controller.brd

## EAGLE design Gen3Electronics/Extruder-2.2/EAGLE/extruder-controller.brd (2024-11-07)

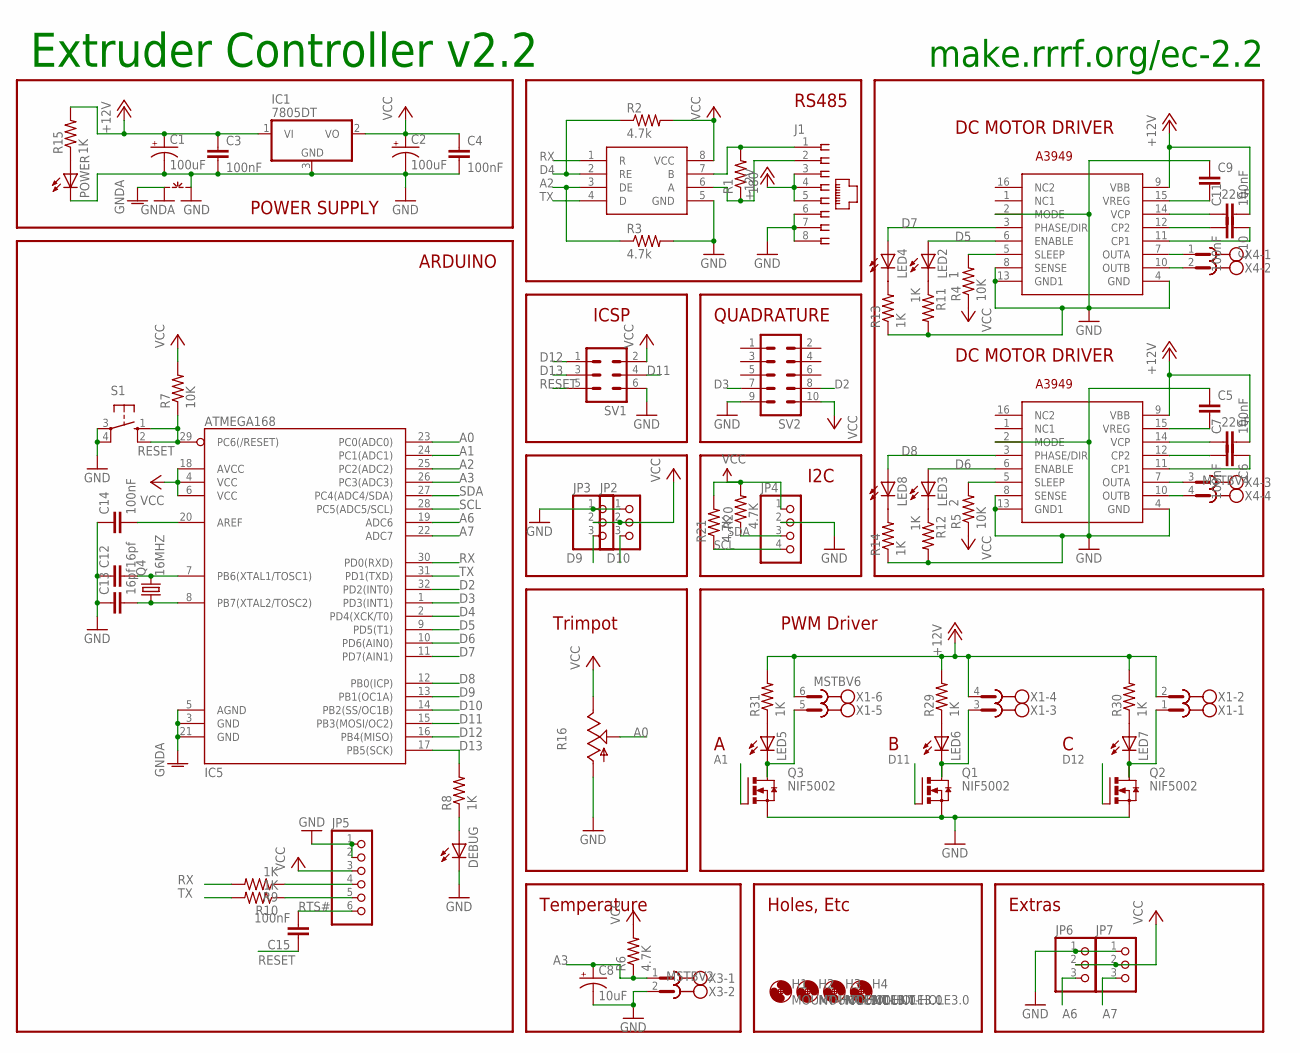
[picture p10: schematic extruder-controller.sch]

Parts:
C1, C2: 100uF; UD-10X10_NICHICON
C3, C4, C14, C15: 100nF; C1206
C5, C9: .22uF; C1206K
C6, C7, C10, C11: 100nF; C1206K
C8: 10uF; UD-6,3X5,8_NICHICON
C12, C13: 16pf; C1206
DEBUG: LEDCHIPLED_1206; CHIPLED_1206
H1, H2, H3, H4: MOUNT-HOLE3.0; 3,0
IC1: 7805DT; TO252
IC2, IC3: A3949; SO16W
IC4: SN75176ASOIC; SO08
IC5: ATMEGA168; TQFP32-08
J1: 520426-4
JP2, JP3, JP6, JP7: PINHD-1X3; 1X03
JP4: PINHD-1X4; 1X04
JP5: PINHD-1X6; 1X06
LED2: 1; CHIPLED_1206
LED3: 2; CHIPLED_1206
LED4, LED5, LED6, LED7, LED8: LEDCHIPLED_1206; CHIPLED_1206
POWER: LEDCHIPLED_1206; CHIPLED_1206
Q1, Q2, Q3: NIF5002; SOT223
Q4: 16MHZ; HC49/S
R1: 180; R1206
R2, R3: 4.7k; R1206
R4, R5, R7: 10K; R1206
R6: 4.7K; M1206
R8, R9, R10, R11, R12, R13, R14, R15, R29, R30: 1K; R1206
R16: TRIM_US-B25P; B25P
R20, R21: 4.7K; R1206
R31: 1K; M1206
S1: 10-XX; B3F-10XX
SV1: ML6
SV2: ML10
X1: MSTBV6
X3: MSTBV2
X4: MSTBV4
~NUDEV~1: GND-GNDA

Connections:
+12V: C1.+, C3.1, C7.2, C11.2, IC1.1 (VI), IC2.9 (VBB), IC3.9 (VBB), J1.3, J1.4, J1.5, R15.2, R29.2, R30.2, R31.2, X1.2, X1.4, X1.6
A0: IC5.23 (PC0(ADC0)), R16.S
A1: IC5.24 (PC1(ADC1)), Q3.1 (G)
A2: IC4.3 (DE), IC5.25 (PC2(ADC2)), R3.1
A3: C8.+, IC5.26 (PC3(ADC3)), R6.1, X3.1
A6: IC5.19 (ADC6), JP6.3
A7: IC5.22 (ADC7), JP7.3
D2: IC5.32 (PD2(INT0)), SV2.8
D3: IC5.1 (PD3(INT1)), SV2.7
D4: IC4.2 (RE), IC5.2 (PD4(XCK/T0)), R2.1
D5: IC2.6 (ENABLE), IC5.9 (PD5(T1)), LED2.A
D6: IC3.6 (ENABLE), IC5.10 (PD6(AIN0)), LED3.A
D7: IC2.3 (PHASE/DIR), IC5.11 (PD7(AIN1)), LED4.A
D8: IC3.3 (PHASE/DIR), IC5.12 (PB0(ICP)), LED8.A
D9: IC5.13 (PB1(OC1A)), JP3.3
D10: IC5.14 (PB2(SS/OC1B)), JP2.3
D11: IC5.15 (PB3(MOSI/OC2)), Q1.1 (G), SV1.4
D12: IC5.16 (PB4(MISO)), Q2.1 (G), SV1.1
D13: IC5.17 (PB5(SCK)), R8.2, SV1.3
GND: C1.-, C2.-, C3.2, C4.2, C5.1, C8.-, C9.1, C12.1, C13.1, C14.1, DEBUG.C, IC1.3 (GND), IC2.2 (MODE), IC2.4 (GND), IC2.8 (SENSE), IC2.13 (GND1), IC3.2 (MODE), IC3.4 (GND), IC3.8 (SENSE), IC3.13 (GND1), IC4.5 (GND), J1.6, J1.7, J1.8, JP2.1, JP3.1, JP4.2, JP5.1, JP5.2, JP6.1, JP7.1, POWER.C, Q1.3 (S), Q2.3 (S), Q3.3 (S), R3.2, R11.2, R12.2, R13.1, R14.1, R16.A, S1.3, S1.4 (P1), SV1.6, SV2.9, X3.2, ~NUDEV~1.GND
GNDA: IC5.3 (GND), IC5.5 (AGND), IC5.21 (GND), ~NUDEV~1.GNDA
unnamed: IC4.7 (B), J1.1, R1.2
unnamed: IC4.6 (A), J1.2, R1.1
unnamed: C9.2, IC2.15 (VREG)
unnamed: IC2.7 (OUTA), X4.1
unnamed: IC2.10 (OUTB), X4.2
unnamed: C10.2, IC2.12 (CP2)
unnamed: C10.1, IC2.11 (CP1)
unnamed: DEBUG.A, R8.1
unnamed: C11.1, IC2.14 (VCP)
unnamed: IC3.7 (OUTA), X4.3
unnamed: C5.2, IC3.15 (VREG)
unnamed: IC2.5 (SLEEP), R4.2
unnamed: C6.2, IC3.12 (CP2)
unnamed: C6.1, IC3.11 (CP1)
unnamed: C7.1, IC3.14 (VCP)
unnamed: IC3.5 (SLEEP), R5.2
unnamed: IC3.10 (OUTB), X4.4
unnamed: LED2.C, R11.1
unnamed: LED3.C, R12.1
unnamed: C14.2, IC5.20 (AREF)
unnamed: JP5.5, R10.1
unnamed: JP5.4, R9.1
unnamed: LED4.C, R13.2
unnamed: LED8.C, R14.2
unnamed: POWER.A, R15.1
unnamed: C12.2, IC5.7 (PB6(XTAL1/TOSC1)), Q4.2
unnamed: C13.2, IC5.8 (PB7(XTAL2/TOSC2)), Q4.1
unnamed: LED7.C, Q2.2 (D), Q2.4 (D), X1.1
unnamed: LED6.C, Q1.2 (D), Q1.4 (D), X1.3
unnamed: LED5.C, Q3.2 (D), Q3.4 (D), X1.5
unnamed: LED5.A, R31.1
unnamed: LED6.A, R29.1
unnamed: LED7.A, R30.1
RESET: C15.1, IC5.29 (PC6(/RESET)), R7.1, S1.1 (S), S1.2 (S1), SV1.5
RTS#: C15.2, JP5.6
RX: IC4.1 (R), IC5.30 (PD0(RXD)), R9.2
SCL: IC5.28 (PC5(ADC5/SCL)), JP4.4, R21.1
SDA: IC5.27 (PC4(ADC4/SDA)), JP4.3, R20.1
TX: IC4.4 (D), IC5.31 (PD1(TXD)), R10.2
VCC: C2.+, C4.1, IC1.2 (VO), IC4.8 (VCC), IC5.4 (VCC), IC5.6 (VCC), IC5.18 (AVCC), JP2.2, JP3.2, JP4.1, JP5.3, JP6.2, JP7.2, R2.2, R4.1, R5.1, R6.2, R7.2, R16.E, R20.2, R21.2, SV1.2, SV2.10

Notes on the sheet:
Extruder Controller v2.2
POWER SUPPLY
RS485
QUADRATURE
I2C
DC MOTOR DRIVER
PWM Driver
Temperature
ICSP
ARDUINO
Extras
Holes, Etc
make.rrrf.org/ec-2.2
Trimpot

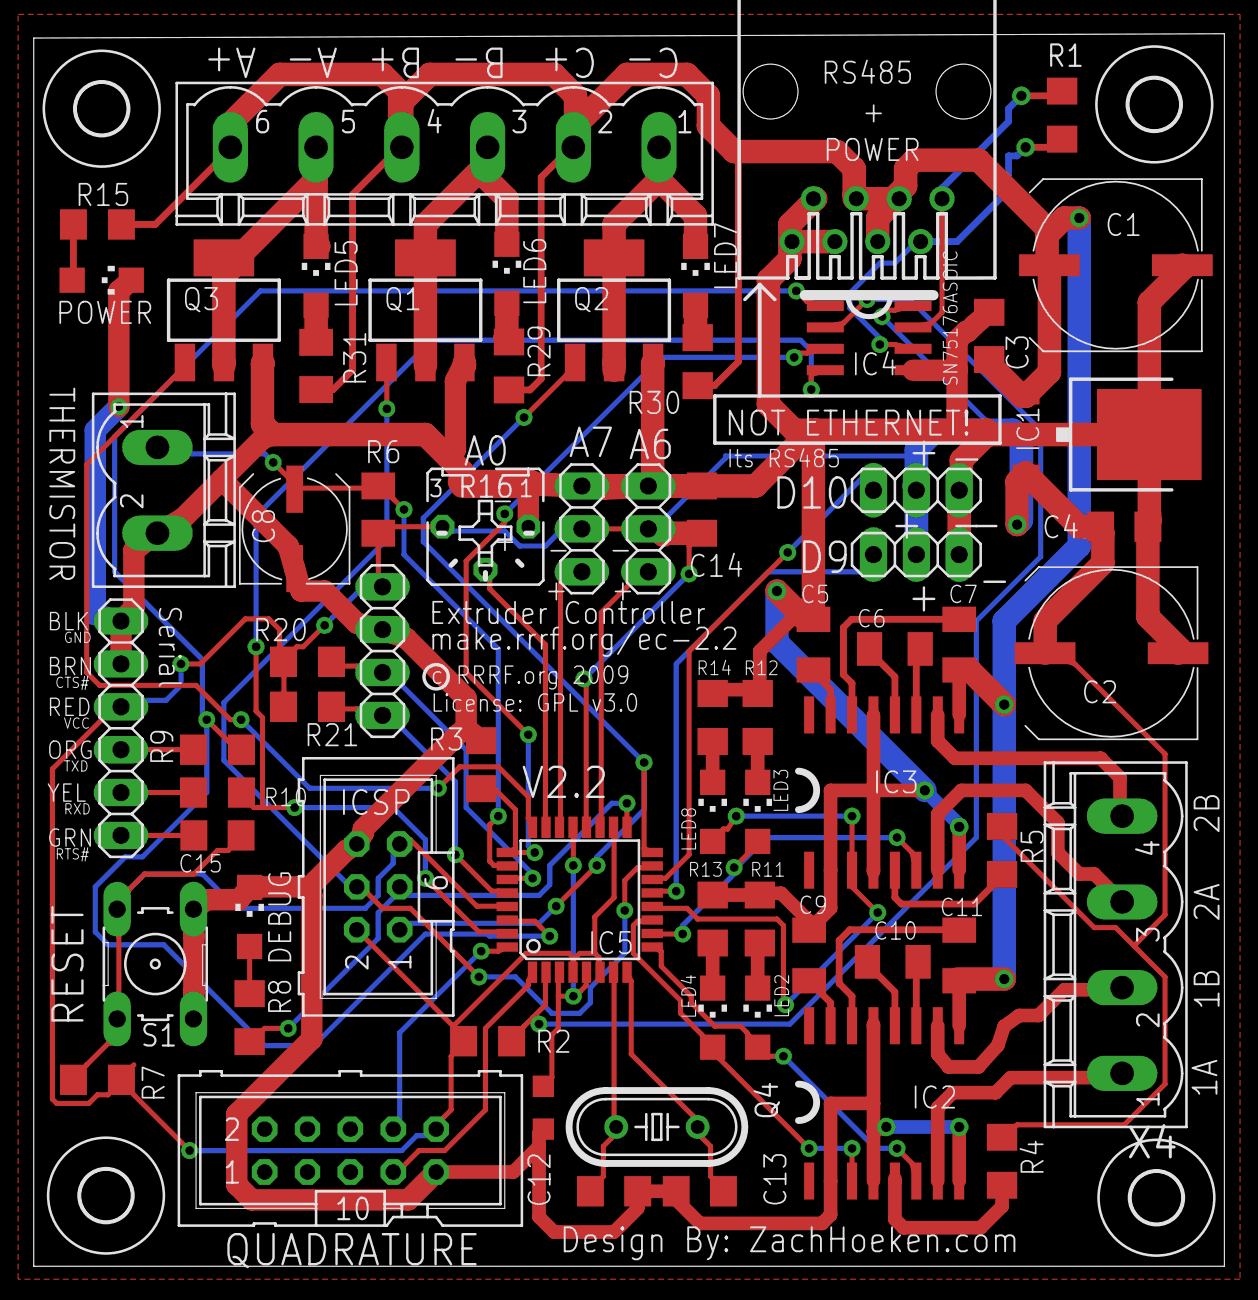
[picture p11: board extruder-controller.brd from above]

Board: 2 copper layers, 70.5 x 73.0 mm, 72 parts (0 on the bottom side), 61 nets.
