comradef191/Cupcake24/(notices)

Notices in the files:
Gen3Electronics/Driver-2.3/stepper-motor-driver.kicad_pcb:
GPLv2
Gen3Electronics/Extruder-2.2/EAGLE/extruder-controller.brd:
License: GPL v3.0
